bence98/LibreEther/README.md

# LibreEther
Free and open source networking devices
