bence98/LibreEther/00_Alexandria/Schematic_LibreEther-Alexandria_2022-07-27.pdf

HV_SWR 65 HV_SWR 66 DVDDIO 67 GND 68 DVDDL 69 EEPROM_MOD/LAN4LED0/GPO39 70 LAN4LED1/GPIO40 71 LAN3LED1/GPIO41 72 EN_PWRLIGHT/GPO42 73 EN_SPIF/LAN3LED0/GPO43 74 DIS_8051/LAN2LED0/GPO44 75 DISAUTOLOAD/GPO45 76 LAN2LED1/GPIO46 77 LAN1LED1/GPIO49 78 EN_PHY/LAN1LED0/GPO50 79 LED_DA/LAN0LED1/GPO51 80 SMI_SEL/LED_CK/LAN0LED0/GPO52 81 AVDDH 82 XTALO 83 XTALI 84 GND 85 nRESET 86 SCK/GPIO54 87 SDA/GPIO55 88 GND 89 AVDDH 90 P0MDIAP 91 P0MDIAN 92 P0MDIBP 93 P0MDIBN 94 AVDDL 95 GND 96 P0MDICP 97 P0MDICN ⁹⁸ GND ⁹⁹ P0MDIDP 100 P0MDIDN ¹⁰¹ AVDDH ¹⁰² P1MDIAP 103 P1MDIAN ¹⁰⁴ GND ¹⁰⁵ P1MDIBP 106 P1MDIBN ¹⁰⁷ AVDDL 108 P1MDICP 109 P1MDICN ¹¹⁰ GND ¹¹¹ P1MDIDP 112 P1MDIDN ¹¹³

## VCC

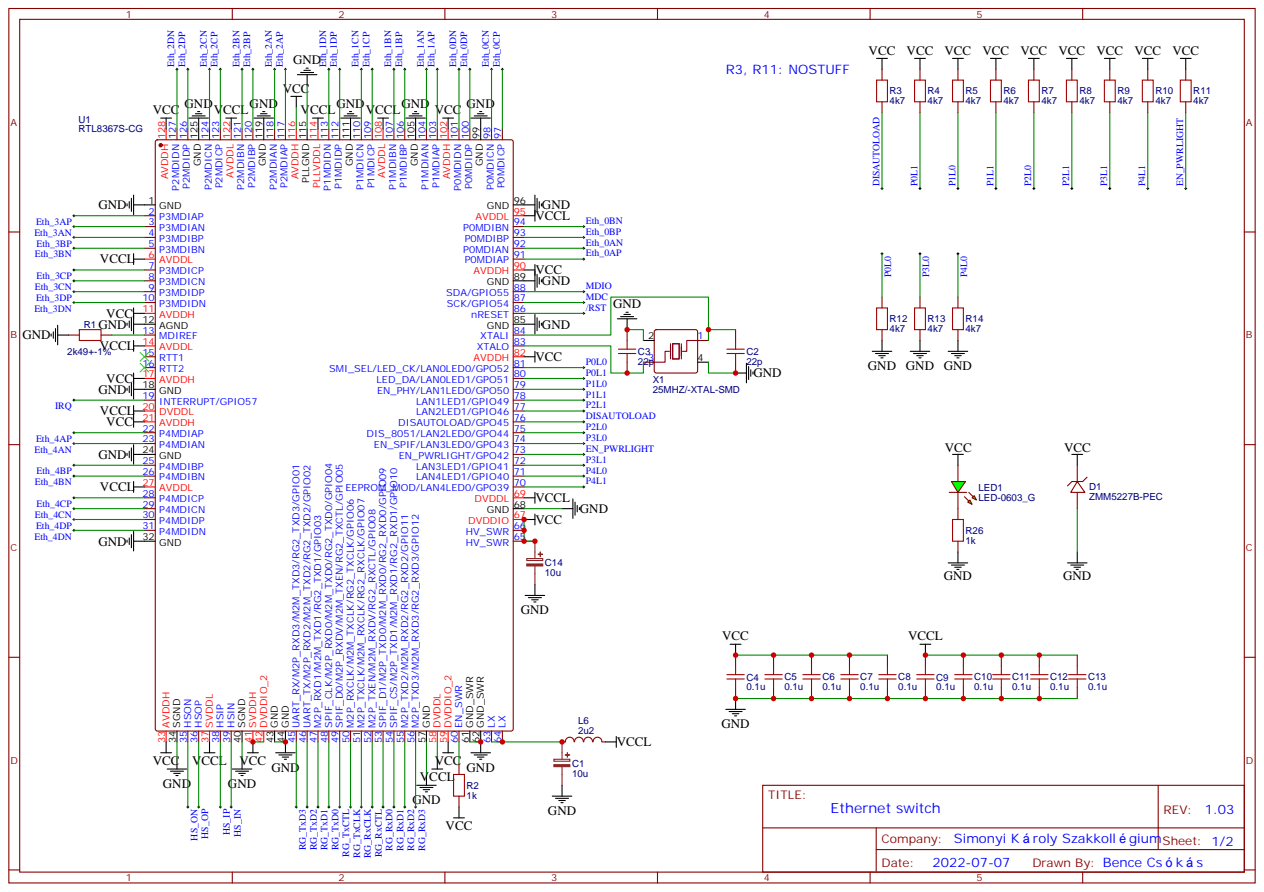
[picture p1: page 1]

Company: Simonyi K roly Szakkoll gium

Drawn By: Bence Cs k s

G2401S:

## Pin compatible with G2415S/2406S

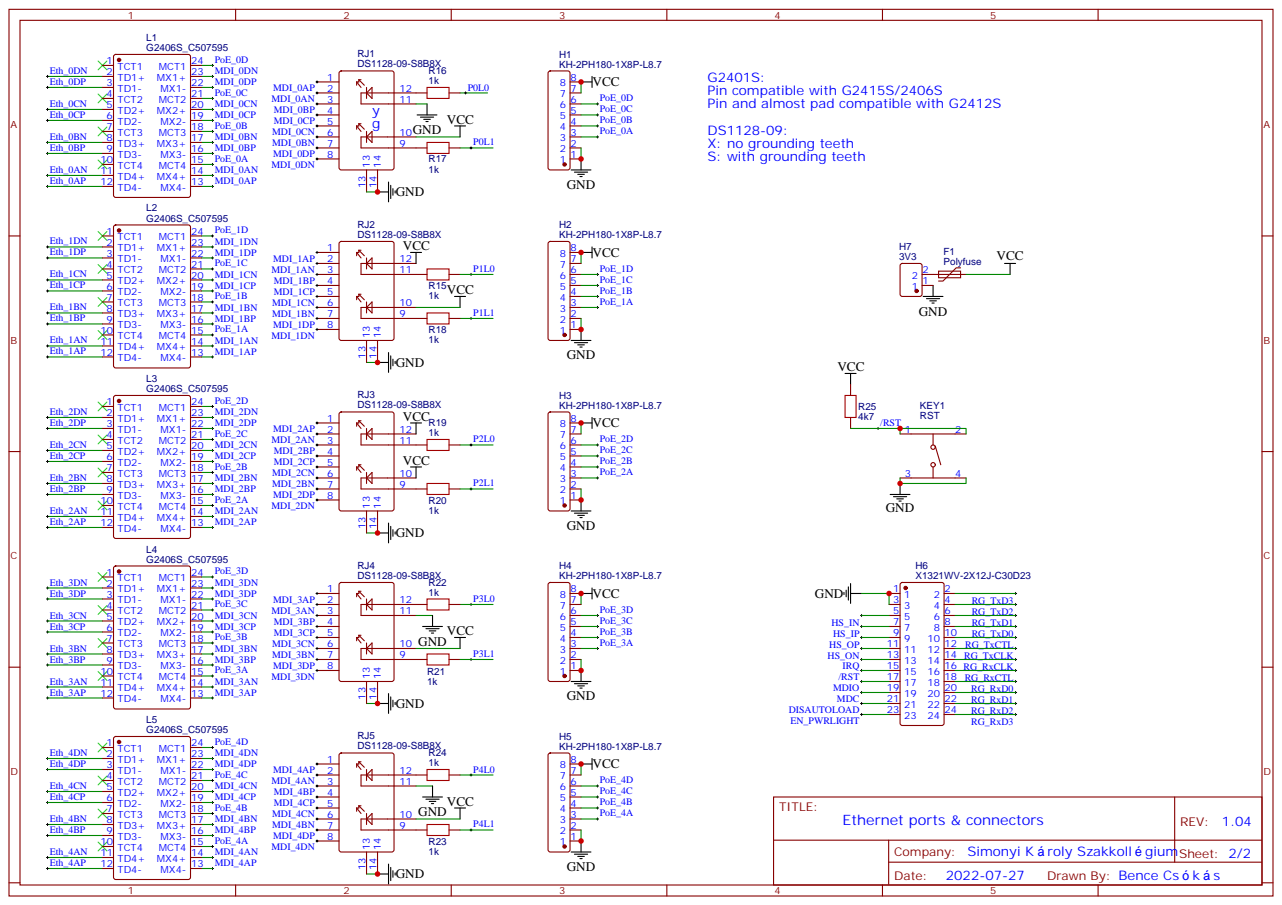
[picture p2: page 2]

Pin and almost pad compatible with G2412S
X: no grounding teeth
S: with grounding teeth

Company: Simonyi K roly Szakkoll gium

Drawn By: Bence Cs k s
