bence98/LibreEther/Alexandria-ng/Alexandria-ng.kicad_pcb

## KiCad design Alexandria-ng/Alexandria-ng.kicad_pcb (2025-05-26)

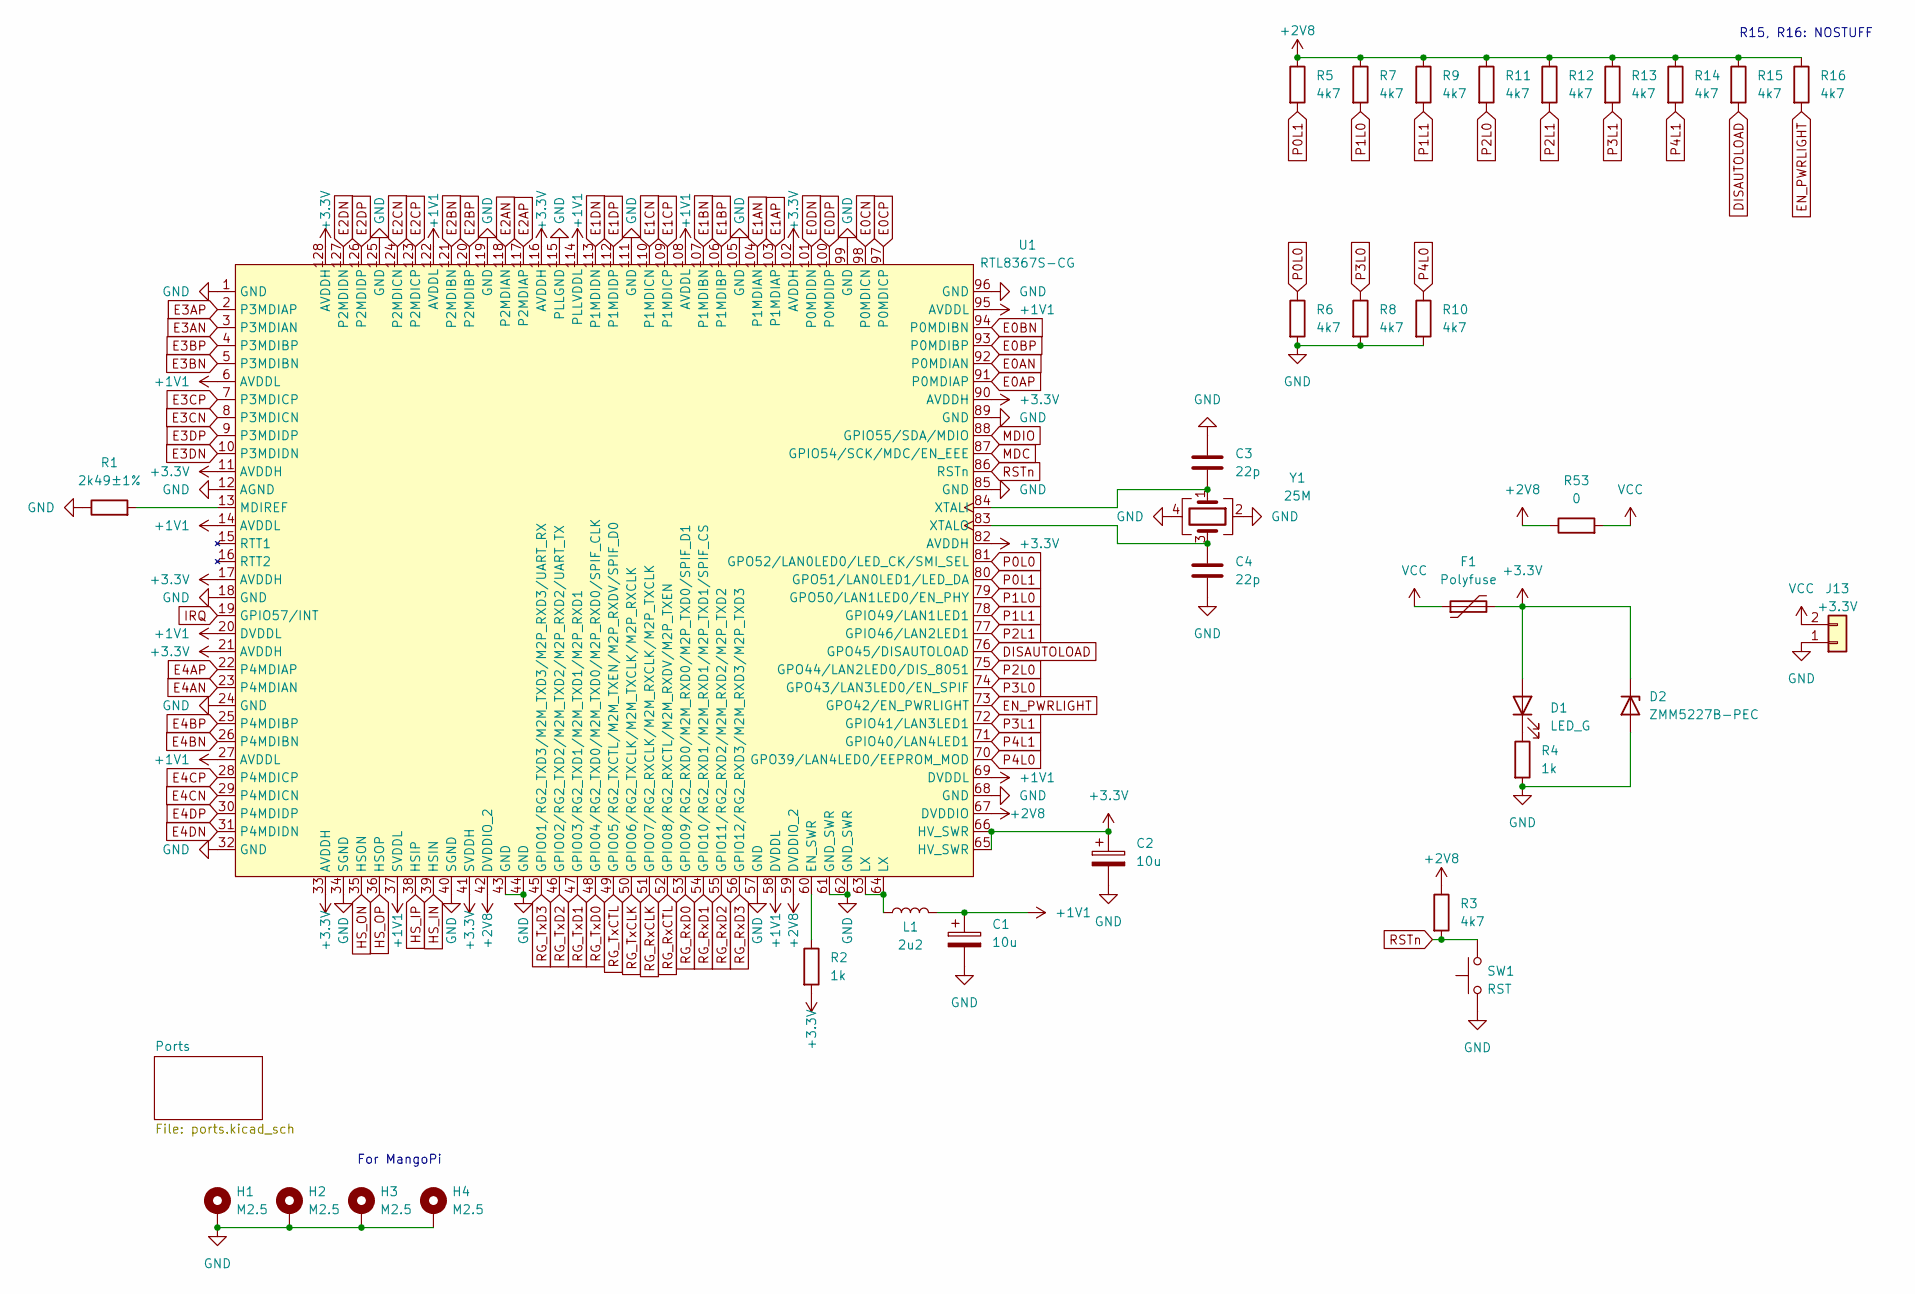
[picture p5: schematic Alexandria-ng.kicad_sch, Alexandria]

Parts:
C1, C2: 10u; C_1206_3216Metric_Pad1.33x1.80mm_HandSolder
C3, C4: 22p; C_0603_1608Metric_Pad1.08x0.95mm_HandSolder
D1: LED_G; LED_0603_1608Metric_Pad1.05x0.95mm_HandSolder
D2: ZMM5227B-PEC; D_MiniMELF_Handsoldering
F1: Polyfuse; Fuse_0603_1608Metric_Pad1.05x0.95mm_HandSolder
H1, H2, H3, H4: M2.5; MountingHole_2.7mm_M2.5_ISO7380_Pad
J13: +3.3V; PinHeader_1x02_P2.54mm_Vertical
L1: 2u2; L_Ferrocore_DLG-0504
R1: 2k49±1%; R_0603_1608Metric_Pad0.98x0.95mm_HandSolder
R2, R4: 1k; R_0603_1608Metric_Pad0.98x0.95mm_HandSolder
R3, R5, R6, R7, R8, R9, R10, R11, R12, R13, R14, R15, R16: 4k7; R_0603_1608Metric_Pad0.98x0.95mm_HandSolder
R53: 0; R_0603_1608Metric_Pad0.98x0.95mm_HandSolder
SW1: RST; SW_Push_1P1T_NO_6x6mm_H9.5mm
U1: RTL8367S-CG; LQFP-128_14x14mm_P0.4mm
Y1: 25M; Crystal_SMD_5032-4Pin_5.0x3.2mm

Connections:
+1V1: C1.1, L1.2, U1.6 (AVDDL), U1.14 (AVDDL), U1.20 (DVDDL), U1.27 (AVDDL), U1.37 (SVDDL), U1.58 (DVDDL), U1.69 (DVDDL), U1.95 (AVDDL), U1.108 (AVDDL), U1.114 (PLLVDDL), U1.122 (AVDDL)
+2V8: R3.1, R5.1, R7.1, R9.1, R11.1, R12.1, R13.1, R14.1, R15.1, R16.1, R53.1, U1.42 (DVDDIO_2), U1.59 (DVDDIO_2), U1.67 (DVDDIO); also elsewhere on the board
+3.3V: C2.1, D1.2 (A), D2.1 (K), F1.2, R2.2, U1.11 (AVDDH), U1.17 (AVDDH), U1.21 (AVDDH), U1.33 (AVDDH), U1.41 (SVDDH), U1.65 (HV_SWR), U1.66 (HV_SWR), U1.82 (AVDDH), U1.90 (AVDDH), U1.102 (AVDDH), U1.116 (AVDDH), U1.128 (AVDDH); also elsewhere on the board
DISAUTOLOAD: R15.2, U1.76 (GPO45/DISAUTOLOAD)
E0AN: U1.92 (P0MDIAN); also elsewhere on the board
E0AP: U1.91 (P0MDIAP); also elsewhere on the board
E0BN: U1.94 (P0MDIBN); also elsewhere on the board
E0BP: U1.93 (P0MDIBP); also elsewhere on the board
E0CN: U1.98 (P0MDICN); also elsewhere on the board
E0CP: U1.97 (P0MDICP); also elsewhere on the board
E0DN: U1.101 (P0MDIDN); also elsewhere on the board
E0DP: U1.100 (P0MDIDP); also elsewhere on the board
E1AN: U1.104 (P1MDIAN); also elsewhere on the board
E1AP: U1.103 (P1MDIAP); also elsewhere on the board
E1BN: U1.107 (P1MDIBN); also elsewhere on the board
E1BP: U1.106 (P1MDIBP); also elsewhere on the board
E1CN: U1.110 (P1MDICN); also elsewhere on the board
E1CP: U1.109 (P1MDICP); also elsewhere on the board
E1DN: U1.113 (P1MDIDN); also elsewhere on the board
E1DP: U1.112 (P1MDIDP); also elsewhere on the board
E2AN: U1.118 (P2MDIAN); also elsewhere on the board
E2AP: U1.117 (P2MDIAP); also elsewhere on the board
E2BN: U1.121 (P2MDIBN); also elsewhere on the board
E2BP: U1.120 (P2MDIBP); also elsewhere on the board
E2CN: U1.124 (P2MDICN); also elsewhere on the board
E2CP: U1.123 (P2MDICP); also elsewhere on the board
E2DN: U1.127 (P2MDIDN); also elsewhere on the board
E2DP: U1.126 (P2MDIDP); also elsewhere on the board
E3AN: U1.3 (P3MDIAN); also elsewhere on the board
E3AP: U1.2 (P3MDIAP); also elsewhere on the board
E3BN: U1.5 (P3MDIBN); also elsewhere on the board
E3BP: U1.4 (P3MDIBP); also elsewhere on the board
E3CN: U1.8 (P3MDICN); also elsewhere on the board
E3CP: U1.7 (P3MDICP); also elsewhere on the board
E3DN: U1.10 (P3MDIDN); also elsewhere on the board
E3DP: U1.9 (P3MDIDP); also elsewhere on the board
E4AN: U1.23 (P4MDIAN); also elsewhere on the board
E4AP: U1.22 (P4MDIAP); also elsewhere on the board
E4BN: U1.26 (P4MDIBN); also elsewhere on the board
E4BP: U1.25 (P4MDIBP); also elsewhere on the board
E4CN: U1.29 (P4MDICN); also elsewhere on the board
E4CP: U1.28 (P4MDICP); also elsewhere on the board
E4DN: U1.31 (P4MDIDN); also elsewhere on the board
E4DP: U1.30 (P4MDIDP); also elsewhere on the board
EN_PWRLIGHT: R16.2, U1.73 (GPO42/EN_PWRLIGHT)
GND: C1.2, C2.2, C3.1, C4.2, D2.2 (A), H1.1, H2.1, H3.1, H4.1, J13.1, R1.1, R4.2, R6.2, R8.2, R10.2, SW1.1, U1.1 (GND), U1.12 (AGND), U1.18 (GND), U1.24 (GND), U1.32 (GND), U1.34 (SGND), U1.40 (SGND), U1.43 (GND), U1.44 (GND), U1.57 (GND), U1.61 (GND_SWR), U1.62 (GND_SWR), U1.68 (GND), U1.85 (GND), U1.89 (GND), U1.96 (GND), U1.99 (GND), U1.105 (GND), U1.111 (GND), U1.115 (PLLGND), U1.119 (GND), U1.125 (GND), Y1.2, Y1.4; also elsewhere on the board
HS_IN: U1.39 (HSIN); also elsewhere on the board
HS_IP: U1.38 (HSIP); also elsewhere on the board
HS_ON: U1.35 (HSON); also elsewhere on the board
HS_OP: U1.36 (HSOP); also elsewhere on the board
IRQ: U1.19 (GPIO57/INT); also elsewhere on the board
MDC: U1.87 (GPIO54/SCK/MDC/EN_EEE); also elsewhere on the board
MDIO: U1.88 (GPIO55/SDA/MDIO); also elsewhere on the board
unnamed: D1.1 (K), R4.1
unnamed: L1.1, U1.63 (LX), U1.64 (LX)
unnamed: R2.1, U1.60 (EN_SWR)
unnamed: R1.2, U1.13 (MDIREF)
unnamed: C3.2, U1.84 (XTALI), Y1.1
unnamed: C4.1, U1.83 (XTALO), Y1.3
P0L0: R6.1, U1.81 (GPO52/LAN0LED0/LED_CK/SMI_SEL); also elsewhere on the board
P0L1: R5.2, U1.80 (GPO51/LAN0LED1/LED_DA); also elsewhere on the board
P1L0: R7.2, U1.79 (GPO50/LAN1LED0/EN_PHY); also elsewhere on the board
P1L1: R9.2, U1.78 (GPIO49/LAN1LED1); also elsewhere on the board
P2L0: R11.2, U1.75 (GPO44/LAN2LED0/DIS_8051); also elsewhere on the board
P2L1: R12.2, U1.77 (GPIO46/LAN2LED1); also elsewhere on the board
P3L0: R8.1, U1.74 (GPO43/LAN3LED0/EN_SPIF); also elsewhere on the board
P3L1: R13.2, U1.72 (GPIO41/LAN3LED1); also elsewhere on the board
P4L0: R10.1, U1.70 (GPO39/LAN4LED0/EEPROM_MOD); also elsewhere on the board
P4L1: R14.2, U1.71 (GPIO40/LAN4LED1); also elsewhere on the board
RG_RxCLK: U1.51 (GPIO07/RG2_RXCLK/M2M_RXCLK/M2P_TXCLK); also elsewhere on the board
RG_RxCTL: U1.52 (GPIO08/RG2_RXCTL/M2M_RXDV/M2P_TXEN); also elsewhere on the board
RG_RxD0: U1.53 (GPIO09/RG2_RXD0/M2M_RXD0/M2P_TXD0/SPIF_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); also elsewhere on the board
RG_RxD1: U1.54 (GPIO10/RG2_RXD1/M2M_RXD1/M2P_TXD1/SPIF_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); also elsewhere on the board
RG_RxD2: U1.55 (GPIO11/RG2_RXD2/M2M_RXD2/M2P_TXD2); also elsewhere on the board
RG_RxD3: U1.56 (GPIO12/RG2_RXD3/M2M_RXD3/M2P_TXD3); also elsewhere on the board
RG_TxCLK: U1.50 (GPIO06/RG2_TXCLK/M2M_TXCLK/M2P_RXCLK); also elsewhere on the board
RG_TxCTL: U1.49 (GPIO05/RG2_TXCTL/M2M_TXEN/M2P_RXDV/SPIF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); also elsewhere on the board
RG_TxD0: U1.48 (GPIO04/RG2_TXD0/M2M_TXD0/M2P_RXD0/SPIF_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); also elsewhere on the board
RG_TxD1: U1.47 (GPIO03/RG2_TXD1/M2M_TXD1/M2P_RXD1); also elsewhere on the board
RG_TxD2: U1.46 (GPIO02/RG2_TXD2/M2M_TXD2/M2P_RXD2/UART_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); also elsewhere on the board
RG_TxD3: U1.45 (GPIO01/RG2_TXD3/M2M_TXD3/M2P_RXD3/UART_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); also elsewhere on the board
RSTn: R3.2, SW1.2, U1.86 (RSTn)
VCC: F1.1, J13.2, R53.2

Notes on the sheet:
For MangoPi
R15, R16: NOSTUFF

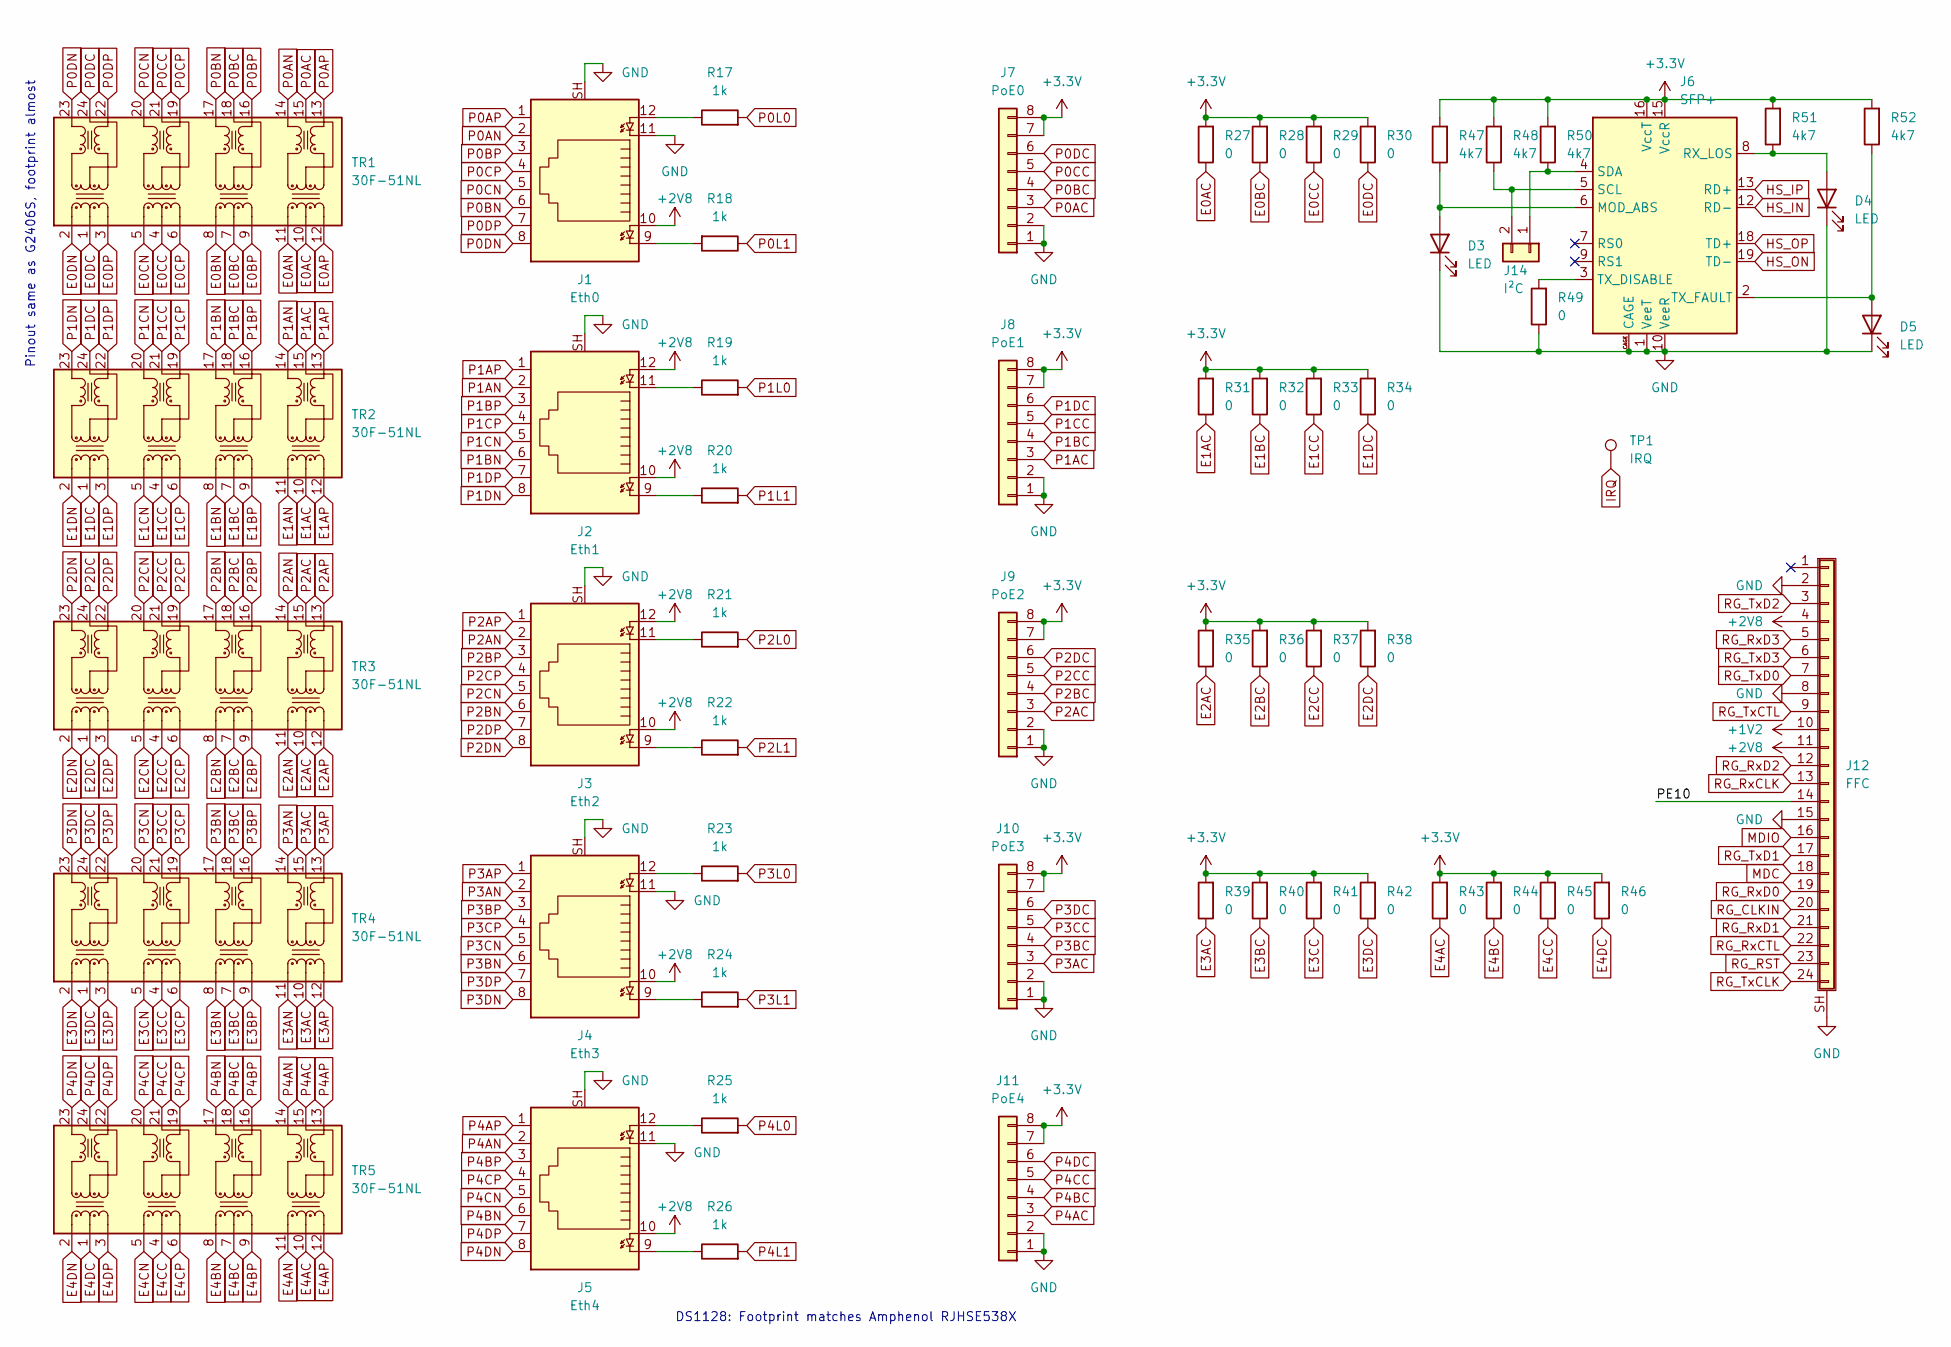
[picture p6: schematic ports.kicad_sch]

Parts:
D3, D4, D5: LED; LED_0603_1608Metric_Pad1.05x0.95mm_HandSolder
J1: Eth0; RJ45_Amphenol_RJHSE538X
J2: Eth1; RJ45_Amphenol_RJHSE538X
J3: Eth2; RJ45_Amphenol_RJHSE538X
J4: Eth3; RJ45_Amphenol_RJHSE538X
J5: Eth4; RJ45_Amphenol_RJHSE538X
J6: SFP+; Connector_SFP_and_Cage
J7: PoE0; PinHeader_1x08_P2.54mm_Vertical
J8: PoE1; PinHeader_1x08_P2.54mm_Vertical
J9: PoE2; PinHeader_1x08_P2.54mm_Vertical
J10: PoE3; PinHeader_1x08_P2.54mm_Vertical
J11: PoE4; PinHeader_1x08_P2.54mm_Vertical
J12: FFC; Jushuo_AFC07-S24FCA-00_1x24-1MP_P0.50_Horizontal
J14: I²C; PinHeader_1x02_P2.54mm_Vertical
R17, R18, R19, R20, R21, R22, R23, R24, R25, R26: 1k; R_0603_1608Metric_Pad0.98x0.95mm_HandSolder
R27, R28, R29, R30, R31, R32, R33, R34, R35, R36, R37, R38, R39, R40, R41, R42, R43, R44, R45, R46, R49: 0; R_0603_1608Metric_Pad0.98x0.95mm_HandSolder
R47, R48, R50, R51, R52: 4k7; R_0603_1608Metric_Pad0.98x0.95mm_HandSolder
TP1: IRQ; TestPoint_Pad_D1.0mm
TR1, TR2, TR3, TR4, TR5: 30F-51NL; Transformer_Ethernet_YDS_30F-51NL_SO-24_7.1x15.1mm

Connections:
+1V2: J12.10
+2V8: J1.10, J2.10, J2.12, J3.10, J3.12, J4.10, J5.10, J12.4, J12.11; also elsewhere on the board
+3.3V: J6.15 (VccR), J6.16 (VccT), J7.7, J7.8, J8.7, J8.8, J9.7, J9.8, J10.7, J10.8, J11.7, J11.8, R27.2, R28.2, R29.2, R30.2, R31.2, R32.2, R33.2, R34.2, R35.2, R36.2, R37.2, R38.2, R39.2, R40.2, R41.2, R42.2, R43.2, R44.2, R45.2, R46.2, R47.2, R48.2, R50.2, R51.2, R52.2; also elsewhere on the board
/Ports/PE10: J12.14
E0AC: R27.1, TR1.10 (CT)
E0AN: TR1.11 (TD4+); also elsewhere on the board
E0AP: TR1.12 (TD4-); also elsewhere on the board
E0BC: R28.1, TR1.7 (CT)
E0BN: TR1.8 (TD3+); also elsewhere on the board
E0BP: TR1.9 (TD3-); also elsewhere on the board
E0CC: R29.1, TR1.4 (CT)
E0CN: TR1.5 (TD2+); also elsewhere on the board
E0CP: TR1.6 (TD2-); also elsewhere on the board
E0DC: R30.1, TR1.1 (CT)
E0DN: TR1.2 (TD1+); also elsewhere on the board
E0DP: TR1.3 (TD1-); also elsewhere on the board
E1AC: R31.1, TR2.10 (CT)
E1AN: TR2.11 (TD4+); also elsewhere on the board
E1AP: TR2.12 (TD4-); also elsewhere on the board
E1BC: R32.1, TR2.7 (CT)
E1BN: TR2.8 (TD3+); also elsewhere on the board
E1BP: TR2.9 (TD3-); also elsewhere on the board
E1CC: R33.1, TR2.4 (CT)
E1CN: TR2.5 (TD2+); also elsewhere on the board
E1CP: TR2.6 (TD2-); also elsewhere on the board
E1DC: R34.1, TR2.1 (CT)
E1DN: TR2.2 (TD1+); also elsewhere on the board
E1DP: TR2.3 (TD1-); also elsewhere on the board
E2AC: R35.1, TR3.10 (CT)
E2AN: TR3.11 (TD4+); also elsewhere on the board
E2AP: TR3.12 (TD4-); also elsewhere on the board
E2BC: R36.1, TR3.7 (CT)
E2BN: TR3.8 (TD3+); also elsewhere on the board
E2BP: TR3.9 (TD3-); also elsewhere on the board
E2CC: R37.1, TR3.4 (CT)
E2CN: TR3.5 (TD2+); also elsewhere on the board
E2CP: TR3.6 (TD2-); also elsewhere on the board
E2DC: R38.1, TR3.1 (CT)
E2DN: TR3.2 (TD1+); also elsewhere on the board
E2DP: TR3.3 (TD1-); also elsewhere on the board
E3AC: R39.1, TR4.10 (CT)
E3AN: TR4.11 (TD4+); also elsewhere on the board
E3AP: TR4.12 (TD4-); also elsewhere on the board
E3BC: R40.1, TR4.7 (CT)
E3BN: TR4.8 (TD3+); also elsewhere on the board
E3BP: TR4.9 (TD3-); also elsewhere on the board
E3CC: R41.1, TR4.4 (CT)
E3CN: TR4.5 (TD2+); also elsewhere on the board
E3CP: TR4.6 (TD2-); also elsewhere on the board
E3DC: R42.1, TR4.1 (CT)
E3DN: TR4.2 (TD1+); also elsewhere on the board
E3DP: TR4.3 (TD1-); also elsewhere on the board
E4AC: R43.1, TR5.10 (CT)
E4AN: TR5.11 (TD4+); also elsewhere on the board
E4AP: TR5.12 (TD4-); also elsewhere on the board
E4BC: R44.1, TR5.7 (CT)
E4BN: TR5.8 (TD3+); also elsewhere on the board
E4BP: TR5.9 (TD3-); also elsewhere on the board
E4CC: R45.1, TR5.4 (CT)
E4CN: TR5.5 (TD2+); also elsewhere on the board
E4CP: TR5.6 (TD2-); also elsewhere on the board
E4DC: R46.1, TR5.1 (CT)
E4DN: TR5.2 (TD1+); also elsewhere on the board
E4DP: TR5.3 (TD1-); also elsewhere on the board
GND: D3.1 (K), D4.1 (K), D5.1 (K), J1.11, J1.SH, J2.SH, J3.SH, J4.11, J4.SH, J5.11, J5.SH, J6.1 (VeeT), J6.10 (VeeR), J6.11 (VeeR), J6.14 (VeeR), J6.17 (VeeT), J6.20 (VeeT), J6.CAGE, J7.1, J7.2, J8.1, J8.2, J9.1, J9.2, J10.1, J10.2, J11.1, J11.2, J12.2, J12.8, J12.15, J12.SH (Shield), R49.1; also elsewhere on the board
HS_IN: J6.12 (RD-); also elsewhere on the board
HS_IP: J6.13 (RD+); also elsewhere on the board
HS_ON: J6.19 (TD-); also elsewhere on the board
HS_OP: J6.18 (TD+); also elsewhere on the board
IRQ: TP1.1; also elsewhere on the board
MDC: J12.18; also elsewhere on the board
MDIO: J12.16; also elsewhere on the board
unnamed: D3.2 (A), J6.6 (MOD_ABS), R47.1
unnamed: D4.2 (A), J6.8 (RX_LOS), R51.1
unnamed: D5.2 (A), J6.2 (TX_FAULT), R52.1
unnamed: J1.9, R18.2
unnamed: J1.12, R17.1
unnamed: J2.9, R20.1
unnamed: J2.11, R19.1
unnamed: J3.9, R22.1
unnamed: J3.11, R21.1
unnamed: J4.9, R24.1
unnamed: J4.12, R23.1
unnamed: J5.9, R26.1
unnamed: J5.12, R25.1
unnamed: J6.3 (TX_DISABLE), R49.2
unnamed: J6.4 (SDA), J14.1, R50.1
unnamed: J6.5 (SCL), J14.2, R48.1
P0AC: J7.3, TR1.15 (CT)
P0AN: J1.2, TR1.14 (MX4+)
P0AP: J1.1, TR1.13 (MX4-)
P0BC: J7.4, TR1.18 (CT)
P0BN: J1.6, TR1.17 (MX3+)
P0BP: J1.3, TR1.16 (MX3-)
P0CC: J7.5, TR1.21 (CT)
P0CN: J1.5, TR1.20 (MX2+)
P0CP: J1.4, TR1.19 (MX2-)
P0DC: J7.6, TR1.24 (CT)
P0DN: J1.8, TR1.23 (MX1+)
P0DP: J1.7, TR1.22 (MX1-)
P0L0: R17.2; also elsewhere on the board
P0L1: R18.1; also elsewhere on the board
P1AC: J8.3, TR2.15 (CT)
P1AN: J2.2, TR2.14 (MX4+)
P1AP: J2.1, TR2.13 (MX4-)
P1BC: J8.4, TR2.18 (CT)
P1BN: J2.6, TR2.17 (MX3+)
P1BP: J2.3, TR2.16 (MX3-)
P1CC: J8.5, TR2.21 (CT)
P1CN: J2.5, TR2.20 (MX2+)
P1CP: J2.4, TR2.19 (MX2-)
P1DC: J8.6, TR2.24 (CT)
P1DN: J2.8, TR2.23 (MX1+)
P1DP: J2.7, TR2.22 (MX1-)
P1L0: R19.2; also elsewhere on the board
P1L1: R20.2; also elsewhere on the board
P2AC: J9.3, TR3.15 (CT)
P2AN: J3.2, TR3.14 (MX4+)
P2AP: J3.1, TR3.13 (MX4-)
P2BC: J9.4, TR3.18 (CT)
P2BN: J3.6, TR3.17 (MX3+)
P2BP: J3.3, TR3.16 (MX3-)
P2CC: J9.5, TR3.21 (CT)
P2CN: J3.5, TR3.20 (MX2+)
P2CP: J3.4, TR3.19 (MX2-)
P2DC: J9.6, TR3.24 (CT)
P2DN: J3.8, TR3.23 (MX1+)
P2DP: J3.7, TR3.22 (MX1-)
P2L0: R21.2; also elsewhere on the board
P2L1: R22.2; also elsewhere on the board
P3AC: J10.3, TR4.15 (CT)
P3AN: J4.2, TR4.14 (MX4+)
P3AP: J4.1, TR4.13 (MX4-)
P3BC: J10.4, TR4.18 (CT)
P3BN: J4.6, TR4.17 (MX3+)
P3BP: J4.3, TR4.16 (MX3-)
P3CC: J10.5, TR4.21 (CT)
P3CN: J4.5, TR4.20 (MX2+)
P3CP: J4.4, TR4.19 (MX2-)
P3DC: J10.6, TR4.24 (CT)
P3DN: J4.8, TR4.23 (MX1+)
P3DP: J4.7, TR4.22 (MX1-)
P3L0: R23.2; also elsewhere on the board
P3L1: R24.2; also elsewhere on the board
P4AC: J11.3, TR5.15 (CT)
P4AN: J5.2, TR5.14 (MX4+)
P4AP: J5.1, TR5.13 (MX4-)
P4BC: J11.4, TR5.18 (CT)
P4BN: J5.6, TR5.17 (MX3+)
P4BP: J5.3, TR5.16 (MX3-)
P4CC: J11.5, TR5.21 (CT)
P4CN: J5.5, TR5.20 (MX2+)
P4CP: J5.4, TR5.19 (MX2-)
P4DC: J11.6, TR5.24 (CT)
P4DN: J5.8, TR5.23 (MX1+)
P4DP: J5.7, TR5.22 (MX1-)
P4L0: R25.2; also elsewhere on the board
P4L1: R26.2; also elsewhere on the board
RG_CLKIN: J12.20
RG_RST: J12.23
RG_RxCLK: J12.13; also elsewhere on the board
RG_RxCTL: J12.22; also elsewhere on the board
RG_RxD0: J12.19; also elsewhere on the board
RG_RxD1: J12.21; also elsewhere on the board
RG_RxD2: J12.12; also elsewhere on the board
RG_RxD3: J12.5; also elsewhere on the board
RG_TxCLK: J12.24; also elsewhere on the board
RG_TxCTL: J12.9; also elsewhere on the board
RG_TxD0: J12.7; also elsewhere on the board
RG_TxD1: J12.17; also elsewhere on the board
RG_TxD2: J12.3; also elsewhere on the board
RG_TxD3: J12.6; also elsewhere on the board

Notes on the sheet:
DS1128: Footprint matches Amphenol RJHSE538X
Pinout same as G2406S, footprint almost

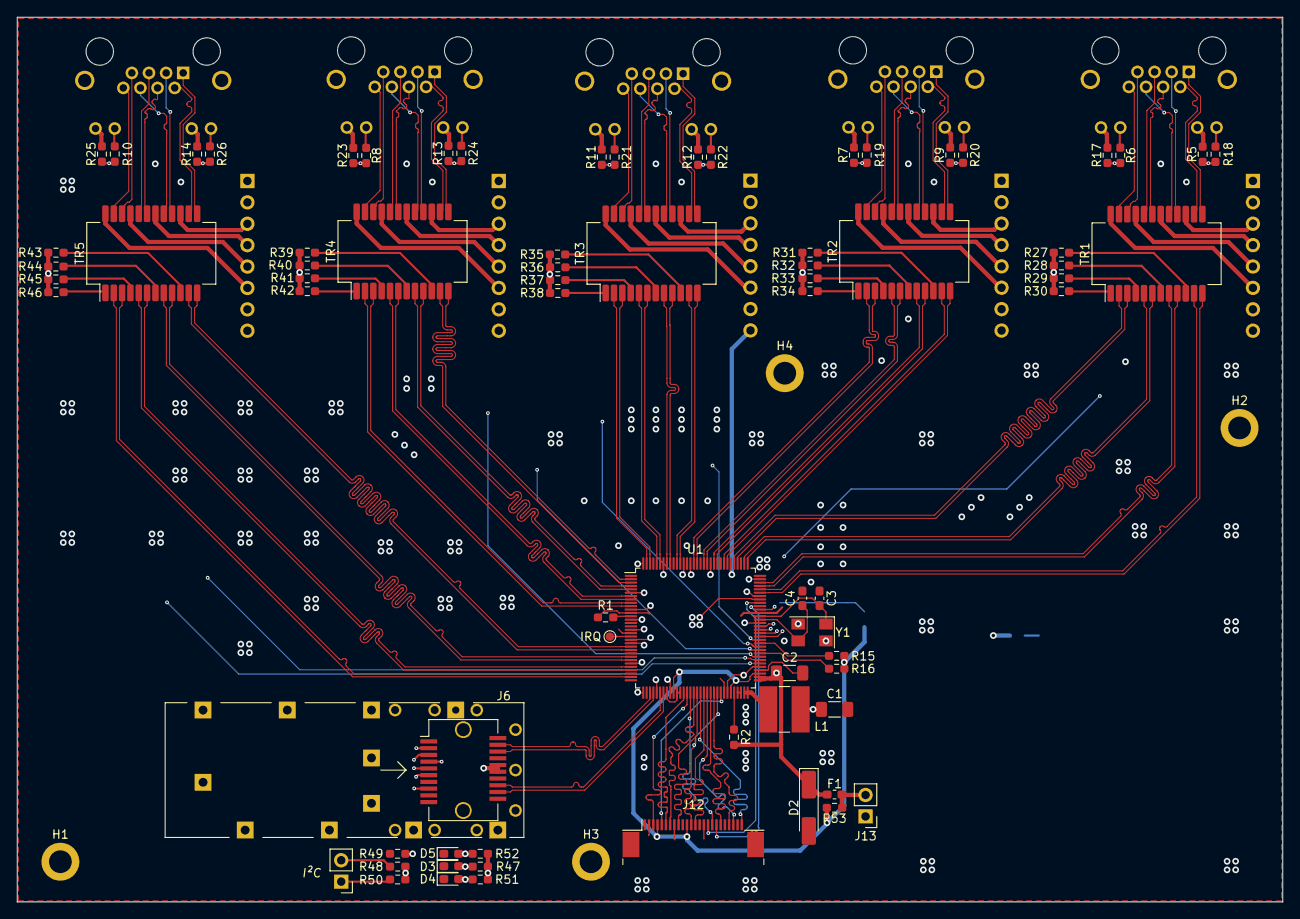
[picture p7: board Alexandria-ng.kicad_pcb from above]

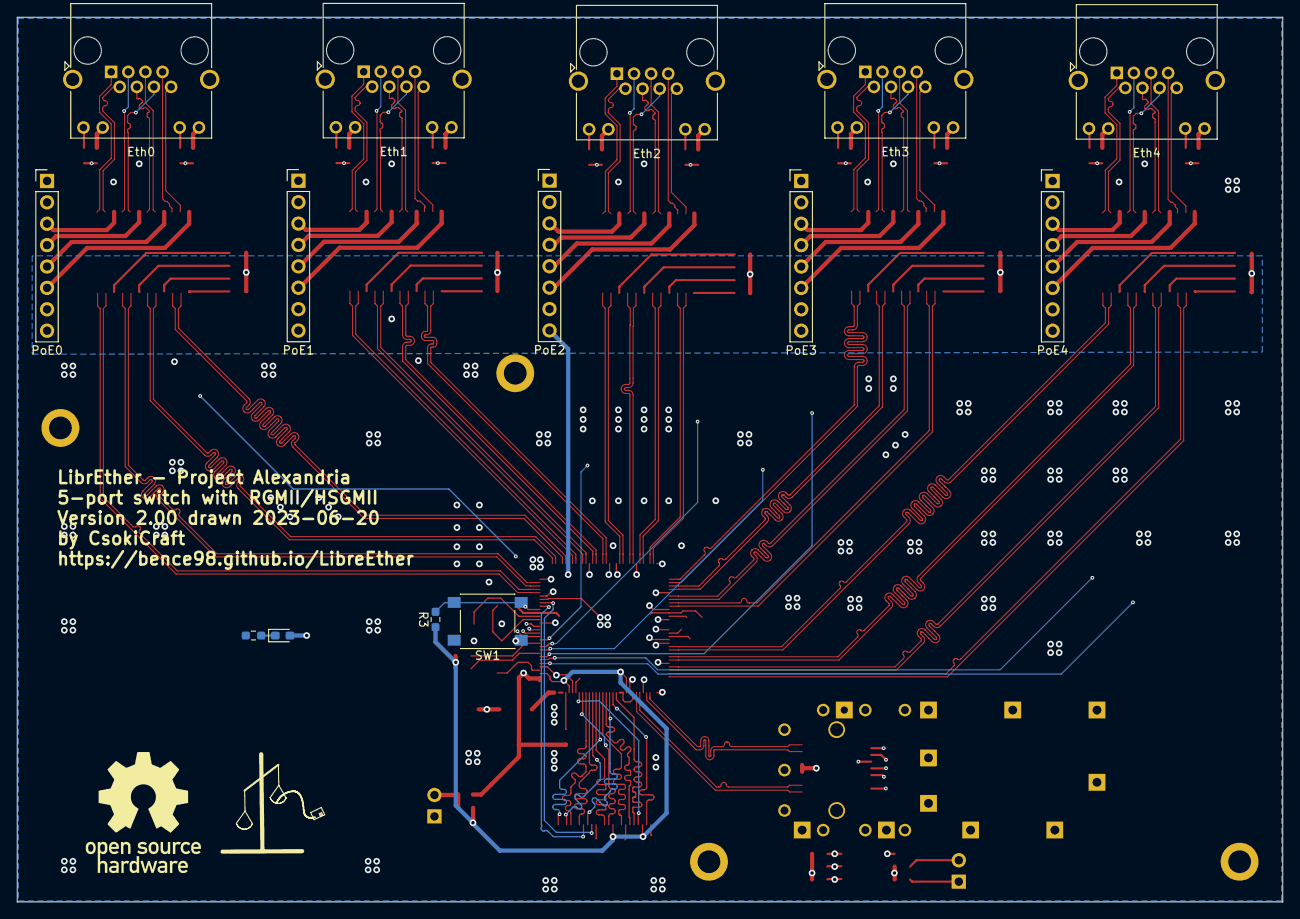
[picture p8: board Alexandria-ng.kicad_pcb from below]

Board: 4 copper layers, 150.2 x 105.0 mm, 91 parts (14 on the bottom side), 179 nets.
