bence98/LibreEther/(commit log)

2022-07-06 Update Alexandria: add protective Zener and polyfuse, power on LED and corner screw holes
    Suggested by @kissadamfkut
2023-03-03 Alexandria re-drawn in KiCad
    [Alexandria-ng.kicad_pcb, Alexandria-ng.kicad_sch, ports.kicad_sch]
2023-03-15 Update to KiCad 7.0, add footprint to RJ45 jacks
    [Alexandria-ng.kicad_sch, ports.kicad_sch]
2023-05-11 Annotate & assign footprints
    [Alexandria-ng.kicad_sch, ports.kicad_sch]
2023-05-12 Re-do VCC and RST, add VCC connector
    [Alexandria-ng.kicad_sch]
2023-05-12 Add IRQ test point & SFP I2C header
    [ports.kicad_sch]
2023-05-18 Beginning PCB design * added JLC 3313 stackup * laid out component groups by function * started routing low speed lines
    [Alexandria-ng.kicad_pcb]
2023-05-19 Re-doing Ethernet magnetics area
    [Alexandria-ng.kicad_pcb]
2023-05-19 Fixing some DRC errors
    [Alexandria-ng.kicad_pcb]
2023-05-21 Tuning Ethernet MDI diff pairs at the RJ45 jack
    [Alexandria-ng.kicad_pcb]
2023-05-21 Routing SGMII to the SFP cage
    [Alexandria-ng.kicad_pcb]
2023-05-21 Switch DVDDIO pins to +2.8V
    [Alexandria-ng.kicad_pcb, Alexandria-ng.kicad_sch, ports.kicad_sch]
2023-05-25 Balance vias on Ethernet jack, unroute RGMII (way too much skew)
    [Alexandria-ng.kicad_pcb]
2023-05-25 Finally routed RGMII with length matching
    [Alexandria-ng.kicad_pcb]
2023-05-25 Change via sizes to new minimum
    [Alexandria-ng.kicad_pcb]
2023-05-26 Finally routed Ethernet pairs, added power rail fills under the IC
    [Alexandria-ng.kicad_pcb]
2023-05-29 Power routing
    [Alexandria-ng.kicad_pcb]
2023-06-03 More power routing
    [Alexandria-ng.kicad_pcb]
2023-06-03 GND improvements
    [Alexandria-ng.kicad_pcb]
2023-06-06 DRC fixes
    [Alexandria-ng.kicad_pcb]
2023-06-10 Finally routed all nets
    [Alexandria-ng.kicad_pcb]
2023-06-20 Added GND vias
    [Alexandria-ng.kicad_pcb]
2023-06-20 Back silkscreen
    [Alexandria-ng.kicad_pcb]
2023-06-21 More silkscreen work
    [Alexandria-ng.kicad_pcb]
2023-06-21 Re-fill zones, fix some DRC warnings
    [Alexandria-ng.kicad_pcb]
2025-05-25 Update project to KiCAD 9.0.1
    No content changes, hopefully
    [Alexandria-ng.kicad_sch, ports.kicad_sch]
2025-05-25 sch: Add mounting holes
    [Alexandria-ng.kicad_sch]
2025-05-25 pcb: Update to KiCAD 9
    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
    [Alexandria-ng.kicad_pcb]
2025-05-25 pcb: Add mounting holes, fix routing of LEDs around it
    [Alexandria-ng.kicad_pcb]
2025-05-25 Raise min. via size to .45
    Even though JLC's min. preferred is .35, they say they can't manufacture
    it without adding 36.14 EUR for 4-wire Kelvin testing...
2025-05-25 pcb: Change via sizes
    [Alexandria-ng.kicad_pcb]
2025-05-25 pcb: Unfill zones
    [Alexandria-ng.kicad_pcb]
2025-05-25 pcb: Move vias to resolve clearance issues
    [Alexandria-ng.kicad_pcb]
2025-05-26 pcb: Resolve DRC errors around Eth jacks
    [Alexandria-ng.kicad_pcb]
